YoungWoongKim9644/parking_system/진행상황 및 결과 문서자료_2/13. todolist 및 기능변경고민.txt

오전 1:20 2020-09-08

1. CLCD 구현

2. 로딩화면 추가 (디버깅 지점 찾기 용이)

3. clcd로 인한 버그 찾고 디버깅
	- i2c_cld_noBackLight
	- i2c_cld_setBackLight 이 두개 버그 있는 느낌이 듬.. 
	- 상황: setBackLight 파라미터0 으로 준 다음에 noBackLight처리해주면 안먹는것같음.

4. 타임아웃 구현해서 로딩 오래걸릴 시, 재부팅 요청 혹은 문제 해결등에 대한 코드 작성하기
	- 아이디어 : 매번 tick이 증가하도록하고, OK시 클리어 . 10000 쌓일 시 재부팅요청

5. 

=======
