YoungWoongKim9644/parking_system/포스터용.pptx

Flow Chart

차량 진입

RFID 체크

데이터 서버로 전송

DB 검색

Registered

Not registered

모터 동작
출입문 개방

개방 알람 음 출력

미등록 알람음 출력

로고젝터 및 CCTV ON

DB 업데이트

차량 주차

## Slide 2

Block diagram

Logo-jector

V2 R pi Cam module
With OpenCV

Display number of availability of parking lot

User
Interface

Gate open/close

- Sends RFID data

RC522
RFID module

Raspberry pi3 B+

Atmega 128A

Led,
buzzer

Steppin
Motor

ESP8266
WIFI module

Send alarm signal

- verify whether register or not

Power ON / OFF

Mysql Database

User info

Log data

Register/
remove

Admin mode

User mode

Send RFID data

## Slide 3

Circuit

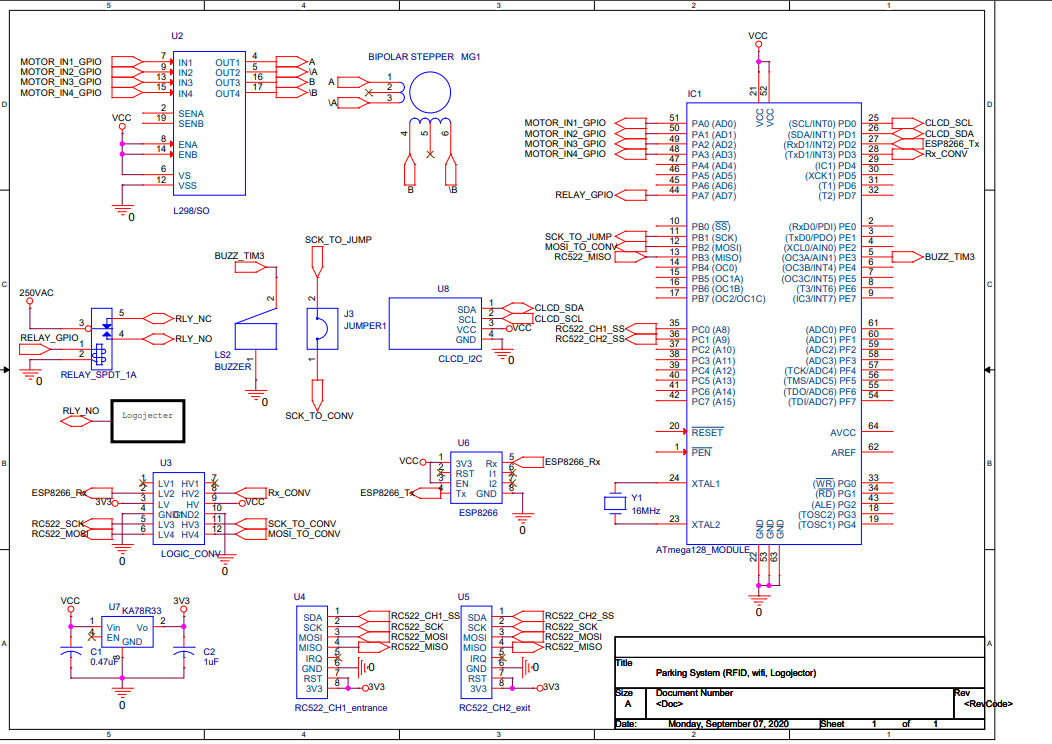
[picture p1: figure]
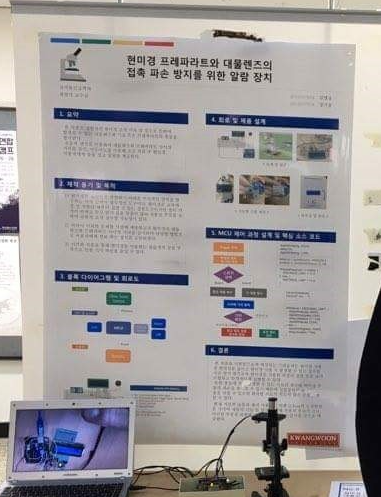
[picture p2: figure]
