YoungWoongKim9644/parking_system/포스터용2.pptx

지역밀착형 캡스톤 디자인 전시회

작품 명: FLAY-GROUND

팀 명: FLAY-GROUND

1. 요약

제작 동기 및 목적

블록 다이어그램 및 회로도

1. 요약

MCU 제어 과정 설계 및 주요 소스 코드

1. 요약

1. 요약

결론

P

1. 요약

제품 설계 및 제작

1. 요약

여긴 뭐쓰지

1. 요약

## Slide 2

P

P
