YoungWoongKim9644/parking_system/진행상황 및 결과 문서자료_2/12. 9월 1째주 시스템다이어그램.pptx

전원 인가 후,
시스템 초기화까지 플로우차트

RFID 연결 체크

RFID 채널 Detect?

전원인가

페리페럴 초기화

CLCD
초기화

ESP8266 모든 초기화 및 연결 성공?

LCD: ‘SYSTEM BOOTING’ 출력

부저: 시스템 부팅 음 발생

2.5초 뒤

부저: ESP8266 서버 연결 성공 음 발생

3초 뒤

LCD: 화면 백 라이트 끔

Main루프 진입

LCD: system firm버전 출력

Y

각 커맨드 명령
마다 10초 타임아웃 카운트

ESP8266 초기화

Y

Y

N

무한 루프 진입 및 LCD:재 부팅요청 출력

## Slide 2

시스템 초기화 이후,
시스템 동작 플로우차트 (입구 RFID 모듈)

루프 진입

200ms마다 RFID 0번 채널 안테나 ON 및 카드 인식 검사

카드 인식?

부저: 실패 음
LCD: 다시 태그 요청

버퍼에 모두 담겼나?

Y

카드 UID 식별 시도

정상적으로 카드가 인식?

부저: 실패 음
LCD: 등록되지 않았습니다

N

Y

N

N

DB에 등록된 유저인가?

N

서버로부터 결과 데이터 받을 때 까지 대기

부저: 성공 음
LCD: ***님 인식되었습니다 (+여석 알림)

부저: 성공 음
LCD: ***님 이미 인식되었습니다

서버로 UID 전송

이미 카드를 찍었던 유저인가?

Y

Y

N

주차장 내 유저 버퍼에 추가

타이머 활성화

모터 동작
(게이트 오픈)

## Slide 3

시스템 초기화 이후,
시스템 동작 플로우차트 (출구 RFID 모듈)

루프 진입

200ms마다 RFID 1번 채널 안테나 ON 및 카드 인식 검사

카드 인식?

부저: 실패 음
LCD: 다시 태그 요청

버퍼에 모두 담겼나?

Y

카드 UID 식별 시도

정상적으로 카드가 인식?

Y

N

N

부저: 성공 음
LCD: 이미 인식 되었습니다

N

DB에 등록된 유저인가?

서버로부터 결과 데이터 받을 때 까지 대기

서버로 UID 전송

N

Y

부저: 성공 음
LCD: 이미 인식 되었습니다

서버로부터 결과 데이터 받을 때 까지 대기

## Slide 4

7초 경과되었는가?

문 닫는
부저 효과음 발생

시스템 초기화 이후,
시스템 동작 플로우차트 (시간 타이머 부분)

루프 진입

타이머 활성화 플래그 ON?

Y

N

10초 경과되었는가?

N

30초 경과되었는가?

N

Y

Y

Y

LCD 화면 클리어 및
백 라이트 OFF

로고젝터 OFF 및
타이머 활성화 플래그 OFF
