YoungWoongKim9644/parking_system/진행상황 및 결과 문서자료_2/시스템 플로우차트_ver0.1.pptx

전원 인가 후,
시스템 초기화까지 플로우차트

CLCD 초기화 성공?

RFID 연결 체크

전원인가

페리페럴 초기화

CLCD
초기화

Y

LCD: ‘SYSTEM BOOTING’ 출력

부저: 시스템 부팅 음 발생

2.5초 뒤

부저: ESP8266 서버 연결 성공 음 발생

3초 뒤

LCD: 화면 백 라이트 끔

Main루프 진입

LCD: system firm버전 출력

Y

ESP8266 모든 초기화 및 연결 성공?

N

각 커맨드 명령
마다 10초 타임아웃 카운트

ESP8266 초기화

Y

RFID 채널 Detect?

N

N

무한 루프 진입 및 LCD:재 부팅요청 출력 및 에러메시지 출력

RFID모듈, LCD, ESP8266 중 하나라도 연결 안되어 있거나 비정상동작을 하면 메인 루프로 못 들어가도록 코딩해둠.

## Slide 2

시스템 초기화 이후,
시스템 동작 플로우차트 (입구 RFID 모듈)

루프 진입

200ms마다 RFID 0번 채널 안테나 ON 및 카드 인식 검사

카드 인식?

부저: 실패 음
LCD: 다시 태그 요청

버퍼에 모두 담겼나?

Y

카드 UID 식별 시도

정상적으로 카드가 인식?

부저: 실패 음
LCD: 등록되지 않았습니다

N

Y

N

N

DB에 등록된 유저인가?

N

서버로부터 결과 데이터 받을 때 까지 대기

부저: 성공 음
LCD: ***님 인식되었습니다 (+여석 알림)

부저: 성공 음
LCD: ***님 이미 인식되었습니다

서버로 UID 전송

이미 카드를 찍었던 유저인가?

Y

Y

N

주차장 내 유저 버퍼에 추가

타이머 활성화

모터 동작
(입구 게이트 오픈)

## Slide 3

시스템 초기화 이후,
시스템 동작 플로우차트 (출구 RFID 모듈)

루프 진입

200ms마다 RFID 1번 채널 안테나 ON 및 카드 인식 검사

카드 인식?

부저: 실패 음
LCD: 다시 태그 요청

Y

카드 UID 식별 시도

정상적으로 카드가 인식?

Y

주차장 내 유저 버퍼에 저장된 카드인가?

N

N

타이머 동작 플래그 활성화

모터 동작
(출구 게이트 오픈)

부저: 성공 음
LCD: 감사합니다. 안녕히가세요

주차장 내 유저 버퍼에서 해당 유저 지움

Y

모터 동작
(출구 게이트 오픈)

부저: 성공 음
LCD: 이미 인식 되었습니다

N

입장여부에 관계없이 출구에서 찍었을 때 우선 무조건 문 열어주도록 했음.

나가는 쪽에서는 서버로 데이터 보내지 않도록 함. =>
DB쪽에서 코드 추가 수정하기 번거로울 것 같음.
나가는 데이터도 DB에 기록해야 한다면, 구현해도 됨.

## Slide 4

7초 경과되었는가?

문 닫는
부저 효과음 발생

시스템 초기화 이후,
시스템 동작 플로우차트 (시간 타이머 부분)

루프 진입

타이머 활성화 플래그 ON?

Y

N

10초 경과되었는가?

N

30초 경과되었는가?

N

Y

Y

Y

LCD 화면 클리어 및
백 라이트 OFF

로고젝터 OFF 및
타이머 활성화 플래그 OFF

## 모터 동작?

2ms 틱을 통해 제어
시작 각도 정의 : 모터 현재 위치를 알 수 있도록 센서가 추가되어야 함
현재 위치를 확인할 변수가 있어야 함.
STATE 변수 : 오픈상태, 클로즈상태
입구게이트, 출구게이트에 대한 정의도 필요함.
