YoungWoongKim9644/parking_system/진행상황 및 결과 문서자료_2/+IPD 형식으로 수신이 가능함.PNG

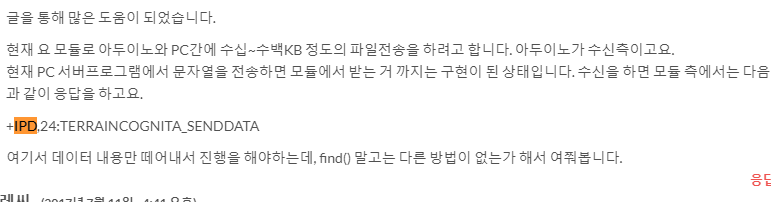
진행상황 및 결과 문서자료_2/+IPD 형식으로 수신이 가능함.PNG
