YoungWoongKim9644/parking_system/진행상황 및 결과 문서자료_2/esp8266 핫스팟으로 Hercules TCP서버와 Linked된 상태.PNG

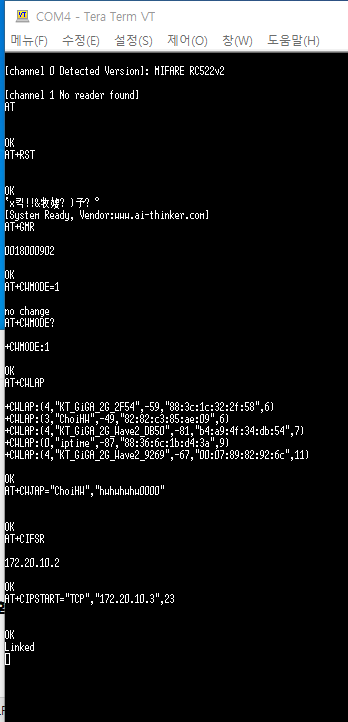
진행상황 및 결과 문서자료_2/esp8266 핫스팟으로 Hercules TCP서버와 Linked된 상태.PNG
