YoungWoongKim9644/parking_system/진행상황 및 결과 문서자료_2/Need for CIPMUX first.PNG

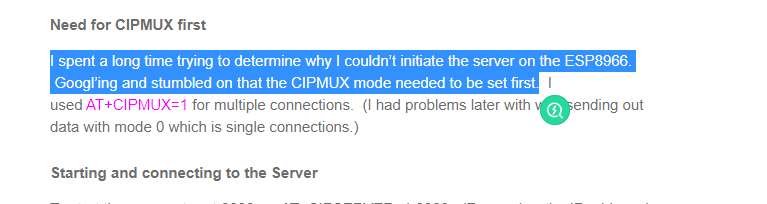
진행상황 및 결과 문서자료_2/Need for CIPMUX first.PNG
