YoungWoongKim9644/parking_system/진행상황 및 결과 문서자료_2/RFID모듈 채널 확장.png

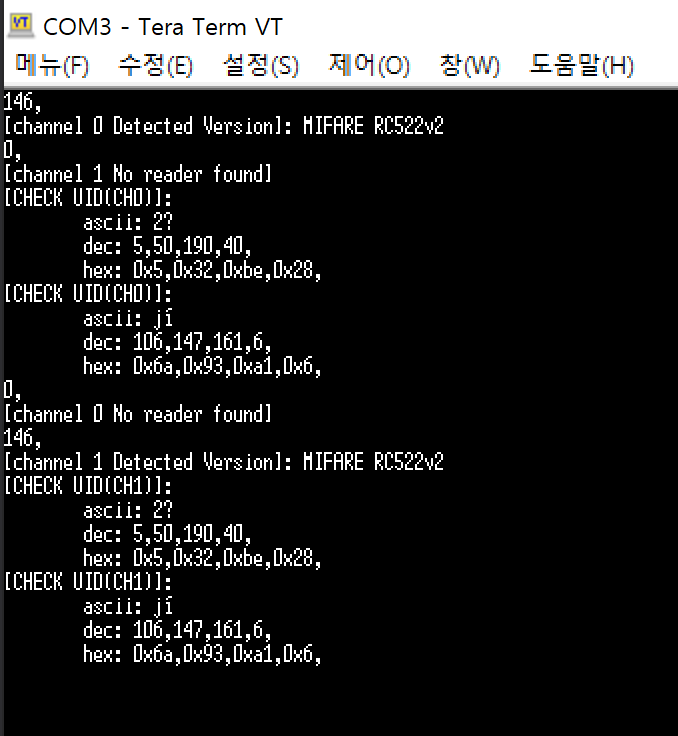
진행상황 및 결과 문서자료_2/RFID모듈 채널 확장.png
