YoungWoongKim9644/parking_system/진행상황 및 결과 문서자료_2/TCP서버에서 atmega로 송신한 데이터를 파싱한 결과_edit.PNG.jpg

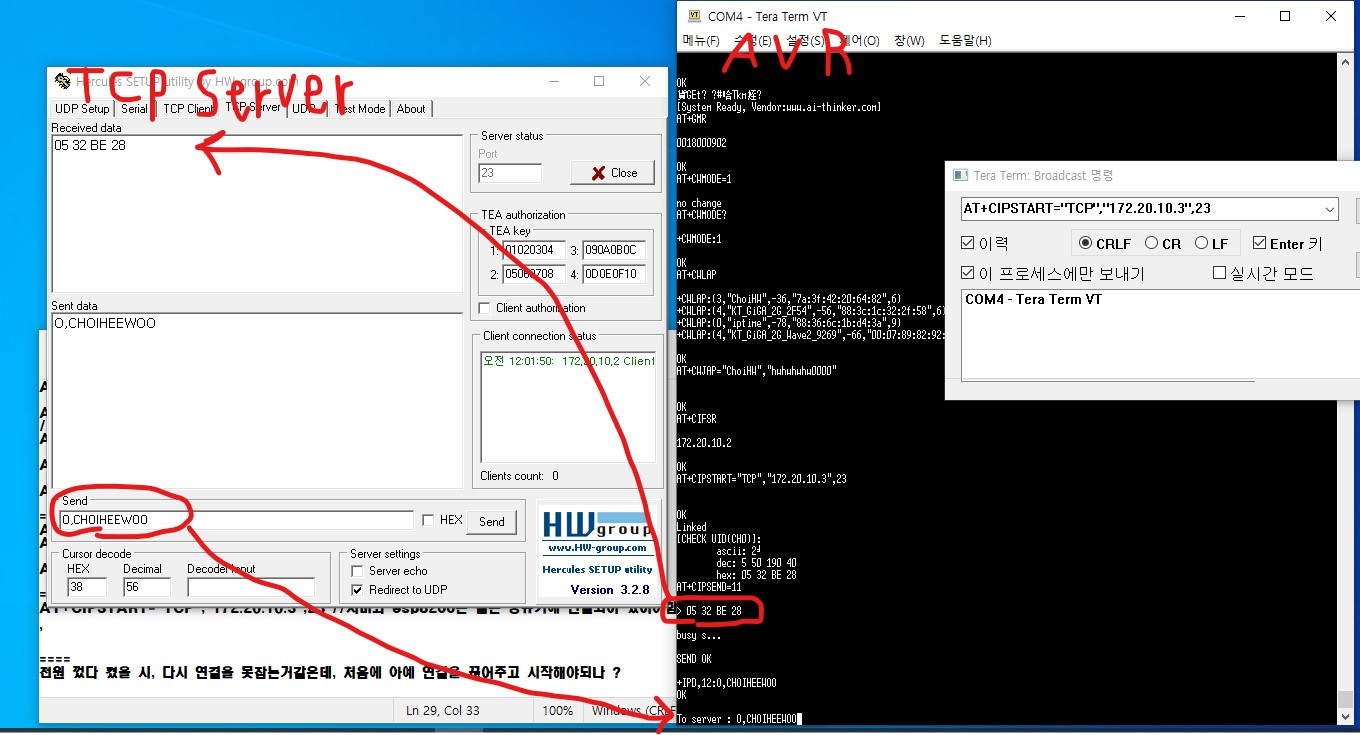
진행상황 및 결과 문서자료_2/TCP서버에서 atmega로 송신한 데이터를 파싱한 결과_edit.PNG.jpg
