YoungWoongKim9644/parking_system/진행상황 및 결과 문서자료_2/새 폴더/6. 라즈베리파이 핀번호.PNG

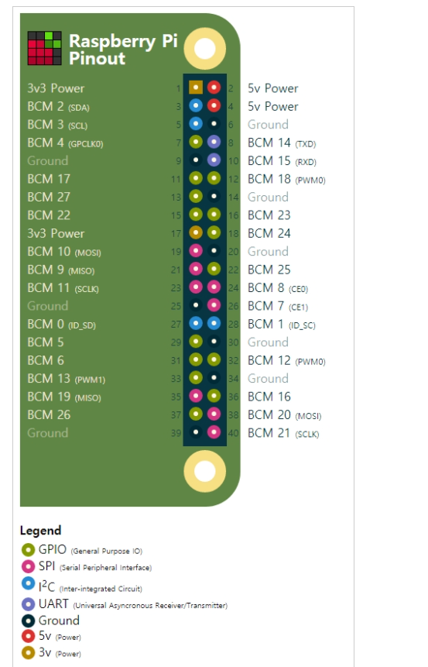
진행상황 및 결과 문서자료_2/새 폴더/6. 라즈베리파이 핀번호.PNG
