YoungWoongKim9644/parking_system/진행상황 및 결과 문서자료_2/현재 esp8266 AT커맨드 보냈을 때 결과 (문제 있음).PNG

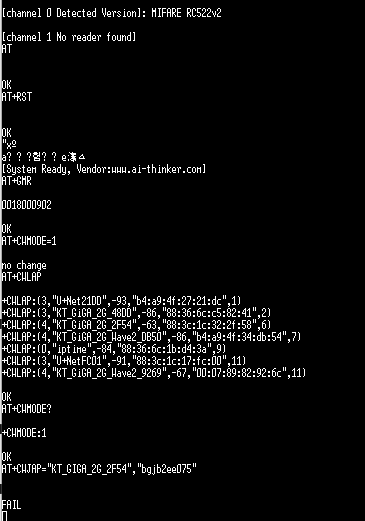
진행상황 및 결과 문서자료_2/현재 esp8266 AT커맨드 보냈을 때 결과 (문제 있음).PNG
