YoungWoongKim9644/parking_system/진행상황 및 결과 문서자료_2/5. TodoList.txt

공부 해야되는 방향?입니다.
아래 읽다가 이해안가거나 모르는 부분이 있으면 사소한 부분이라도 말해주시면 열심히 답해드릴게요.
==============================================================================================
1. 로고젝터 ON/OFF : 릴레이스위치 신호선에 대해 LOW, HIGH 신호 제어만 해주면 됩니다. 특정 신호가 들어왔을 때 스위치를 키고, 이후 또 다른 신호가 들어오거나 N초 뒤에 자동으로 OFF해주는 기능을 만들어 주어야 합니다. 
	=> 공부해야 할 것 : GPIO 공부 및 사용하기, Tick 타이머 공부하기(시간측정) 

2. 모터 (문 제어) : GPIO 출력핀을 4개 사용하여 타이밍에 맞게 펄스를 만들어 주면 돼요. 어떤 주기를 갖고 펄스를 만들어줘야 되는데, 그 주기를 자유자재로 설정할 수 있어야되는데, 그렇게 하려면 타이머카운터를 이용하면 돼요.
	=> 공부해야 할 것 : GPIO 및 스텝모터 관련 용어 및 지식 숙지 필요. 사용하는 모터 제품에 대한 메뉴얼(스텝모터 사용법) 숙지하기. Timer/Counter 공부하기(원하는 타이머 주기 만들수 있도록)  

5. CLCD(유저 인터페이스) : CLCD를 제어하는 방법 중 하나로 'I2C 통신'을 통해 제어를 하게 될 거에요. 제어가 원활해지면(한 바이트 전송하기, 문자열 전송하기, 모두 지우기 등등), 이 모듈을 통해 RFID 신원 정보, 차량 여석 수에 대한 정보를 출력해줄 수 있는 기능을 함수화 해줄 거에요.

	=> 공부해야 할 것 : I2C 통신 공부, 구매한 CLCD 메뉴얼 숙지

===============================================================================================

시작하실 때 쯤, 각각 기능들 (1, 2, 5번)을 각각 프로젝트를 만들어 구현해보시고, 기능이 완성된 것 같다고 생각되면 말씀해주세요. 기능들 합치는거 도와드릴게요. (하다가 막히는거 생겨도 물어봐주세요!)

마지막으로는, 제가 지금까지 작성해둔 코드들 보내드릴텐데, 중구난방 많이 길고 복잡해요. 코드 읽기 힘드시다면 나중에 시간 내서 화상으로 코드 쭉 오버뷰 해드릴게요. 
최종적으론 모든 기능들을 한 프로젝트에 모두 합쳐야되는데, 각 기능들의 타이밍이 제대로 맞지 않으면 어딘가에서 반드시 버그가 발생합니다. 코드 전체 맥락을 이해하고 있어야하죠... 그 만큼 난이도가 높기 때문에 이것도 저랑 같이 얘기해보면서 진행하는 걸루 하면 좋을 것 같아요.

일단 적어놓기는 해봤지만, 실제로 제품을 받아보고 직접 파고 들어봐야 느낌이 오실 것 같아요. 그 전까지는 이론 공부를 해보시고 미리 감 익혀놓으시는게 좋을 것 같아요

졸린채로 적느라 두서 없을 것같아서, 나중에 한번 더 읽어보고 나중에 더 말씀드릴게요 :^)
