YoungWoongKim9644/parking_system/진행상황 및 결과 문서자료_2/circuit.pdf

XTAL2 23 | VCC ²¹ VCC ⁵² GND 22 | GND 53 | GND 63

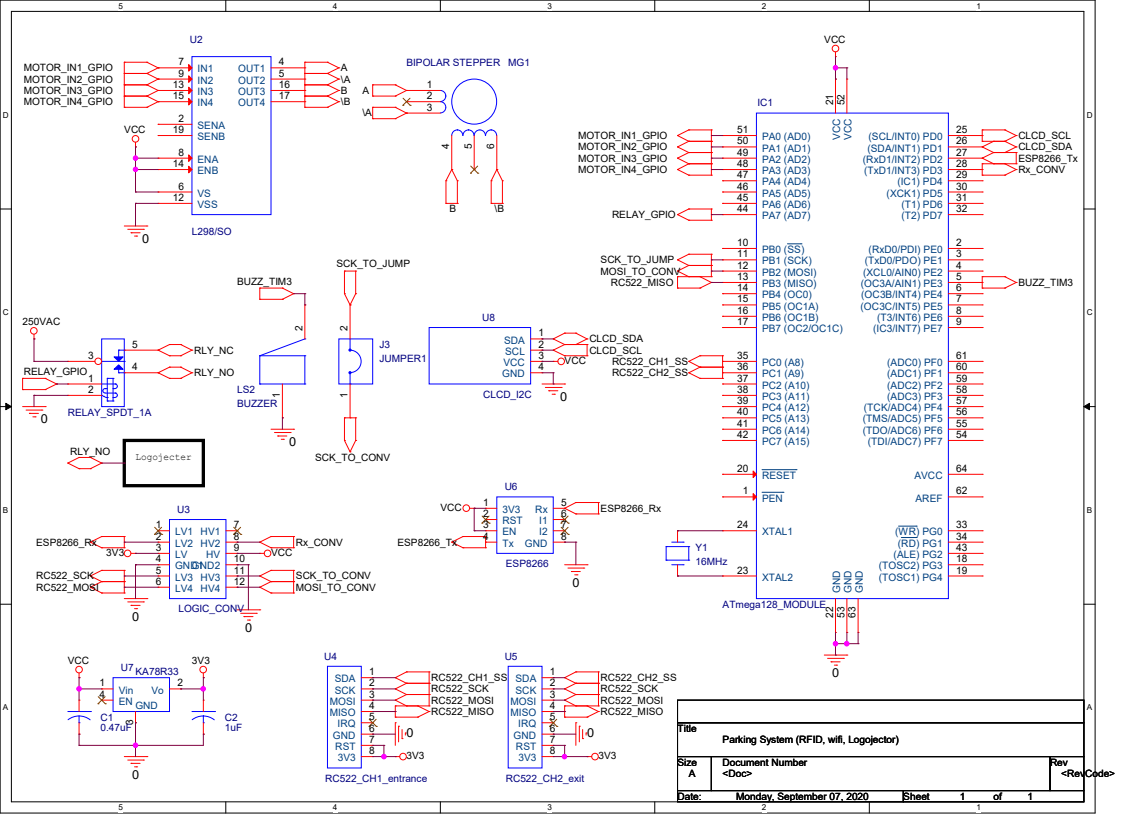
[picture p31: page 1]

(TDI/ADC7) PF7 54 (TDO/ADC6) PF6 55 (TMS/ADC5) PF5 56 (TCK/ADC4) PF4 57 (ADC3) PF3 58 (ADC2) PF2 59 (ADC1) PF1 60 (ADC0) PF0 61

Parking System (RFID, wifi, Logojector)
