YoungWoongKim9644/parking_system/sources/mfrc/simpleMFRC.py

#from MFRC import MFRC522
#import RPi.GPIO as GPIO


class SimpleMFRC522:

    READER = None

    KEY = [0xFF,0xFF,0xFF,0xFF,0xFF,0xFF]
    BLOCK_ADDRS = [8, 9, 10]

    def __init__(self):
        pass
        #self.READER = MFRC522()

    def read(self):

        id = int(input("enter num:"))
        text = "hello"
        """
        id, text = self.read_no_block()
        #print("1")
        while not id:
            id, text = self.read_no_block()
            #print("2")
        """

        return id, text

    def read_id(self):

        id = self.read_id_no_block()
        while not id:
            id = self.read_id_no_block()
        return id

    def read_id_no_block(self):

        (status, TagType) = self.READER.MFRC522_Request(self.READER.PICC_REQIDL)
        #print(status, TagType)
        if status != self.READER.MI_OK:
              return None
        (status, uid) = self.READER.MFRC522_Anticoll()
        if status != self.READER.MI_OK:
            return None

        return self.uid_to_num(uid)

    def read_no_block(self):
        (status, TagType) = self.READER.MFRC522_Request(self.READER.PICC_REQIDL)
        #print(status, TagType)
        if status != self.READER.MI_OK:
            return None, None
        (status, uid) = self.READER.MFRC522_Anticoll()
        if status != self.READER.MI_OK:
            return None, None

        id = self.uid_to_num(uid)
        self.READER.MFRC522_SelectTag(uid)
        status = self.READER.MFRC522_Auth(self.READER.PICC_AUTHENT1A, 11, self.KEY, uid)
        data = []
        text_read = ''
        if status == self.READER.MI_OK:
            for block_num in self.BLOCK_ADDRS:
                block = self.READER.MFRC522_Read(block_num)
                if block:
                        data += block
            if data:
                text_read = ''.join(chr(i) for i in data)
        self.READER.MFRC522_StopCrypto1()
        return id, text_read

    def write(self, text):
        id, text_in = self.write_no_block(text)
        while not id:
            id, text_in = self.write_no_block(text)
        return id, text_in

    def write_no_block(self, text):
        (status, TagType) = self.READER.MFRC522_Request(self.READER.PICC_REQIDL)
        if status != self.READER.MI_OK:
            return None, None
        (status, uid) = self.READER.MFRC522_Anticoll()
        if status != self.READER.MI_OK:
            return None, None
        id = self.uid_to_num(uid)
        self.READER.MFRC522_SelectTag(uid)
        status = self.READER.MFRC522_Auth(self.READER.PICC_AUTHENT1A, 11, self.KEY, uid)
        self.READER.MFRC522_Read(11)
        if status == self.READER.MI_OK:
            data = bytearray()
            data.extend(bytearray(text.ljust(len(self.BLOCK_ADDRS) * 16).encode('ascii')))
            i = 0
            for block_num in self.BLOCK_ADDRS:
                self.READER.MFRC522_Write(block_num, data[(i*16):(i+1)*16])
                i += 1
        self.READER.MFRC522_StopCrypto1()
        return id, text[0:(len(self.BLOCK_ADDRS) * 16)]

    def uid_to_num(self, uid):
        n = 0
        print(uid)
        for i in range(0, 5):
            n = n * 256 + uid[i]
            print(n)

        return n

    def version_check(self):
        print("version check")
        return True
        """
        ver = self.READER.Read_MFRC522(MFRC522.VersionReg)
        print("ver : ",ver)
        if ver == 0x92:
            print("ver: mfrc522v2")
            return True

        elif ver == 0x91 or ver == 0x90:
            print("ver: mfrc522v1")
            return True
        else:
            print("not found")
            return False
        """
