YoungWoongKim9644/parking_system/(notices)

Notices in the files:
sources/mfrc/MFRC.py:
MFRC522-Python is free software: you can redistribute it and/or modify
it under the terms of the GNU Lesser General Public License as published by
the Free Software Foundation, either version 3 of the License, or
(at your option) any later version.
